pepaslabs/OpAmpPassXsistorBenchSupply/README.md

# OpAmpPassXsistorBenchSupply

An adjustable voltage and current limited lab power supply, implemented with a traditional op amp and pass transistor architecture.

# Status

This design is currently broken (it oscillates).  I haven't had time to revisit it yet.
