pepaslabs/OpAmpPassXsistorBenchSupply/OpAmpPassXsistorBenchSupply_schematic.pdf

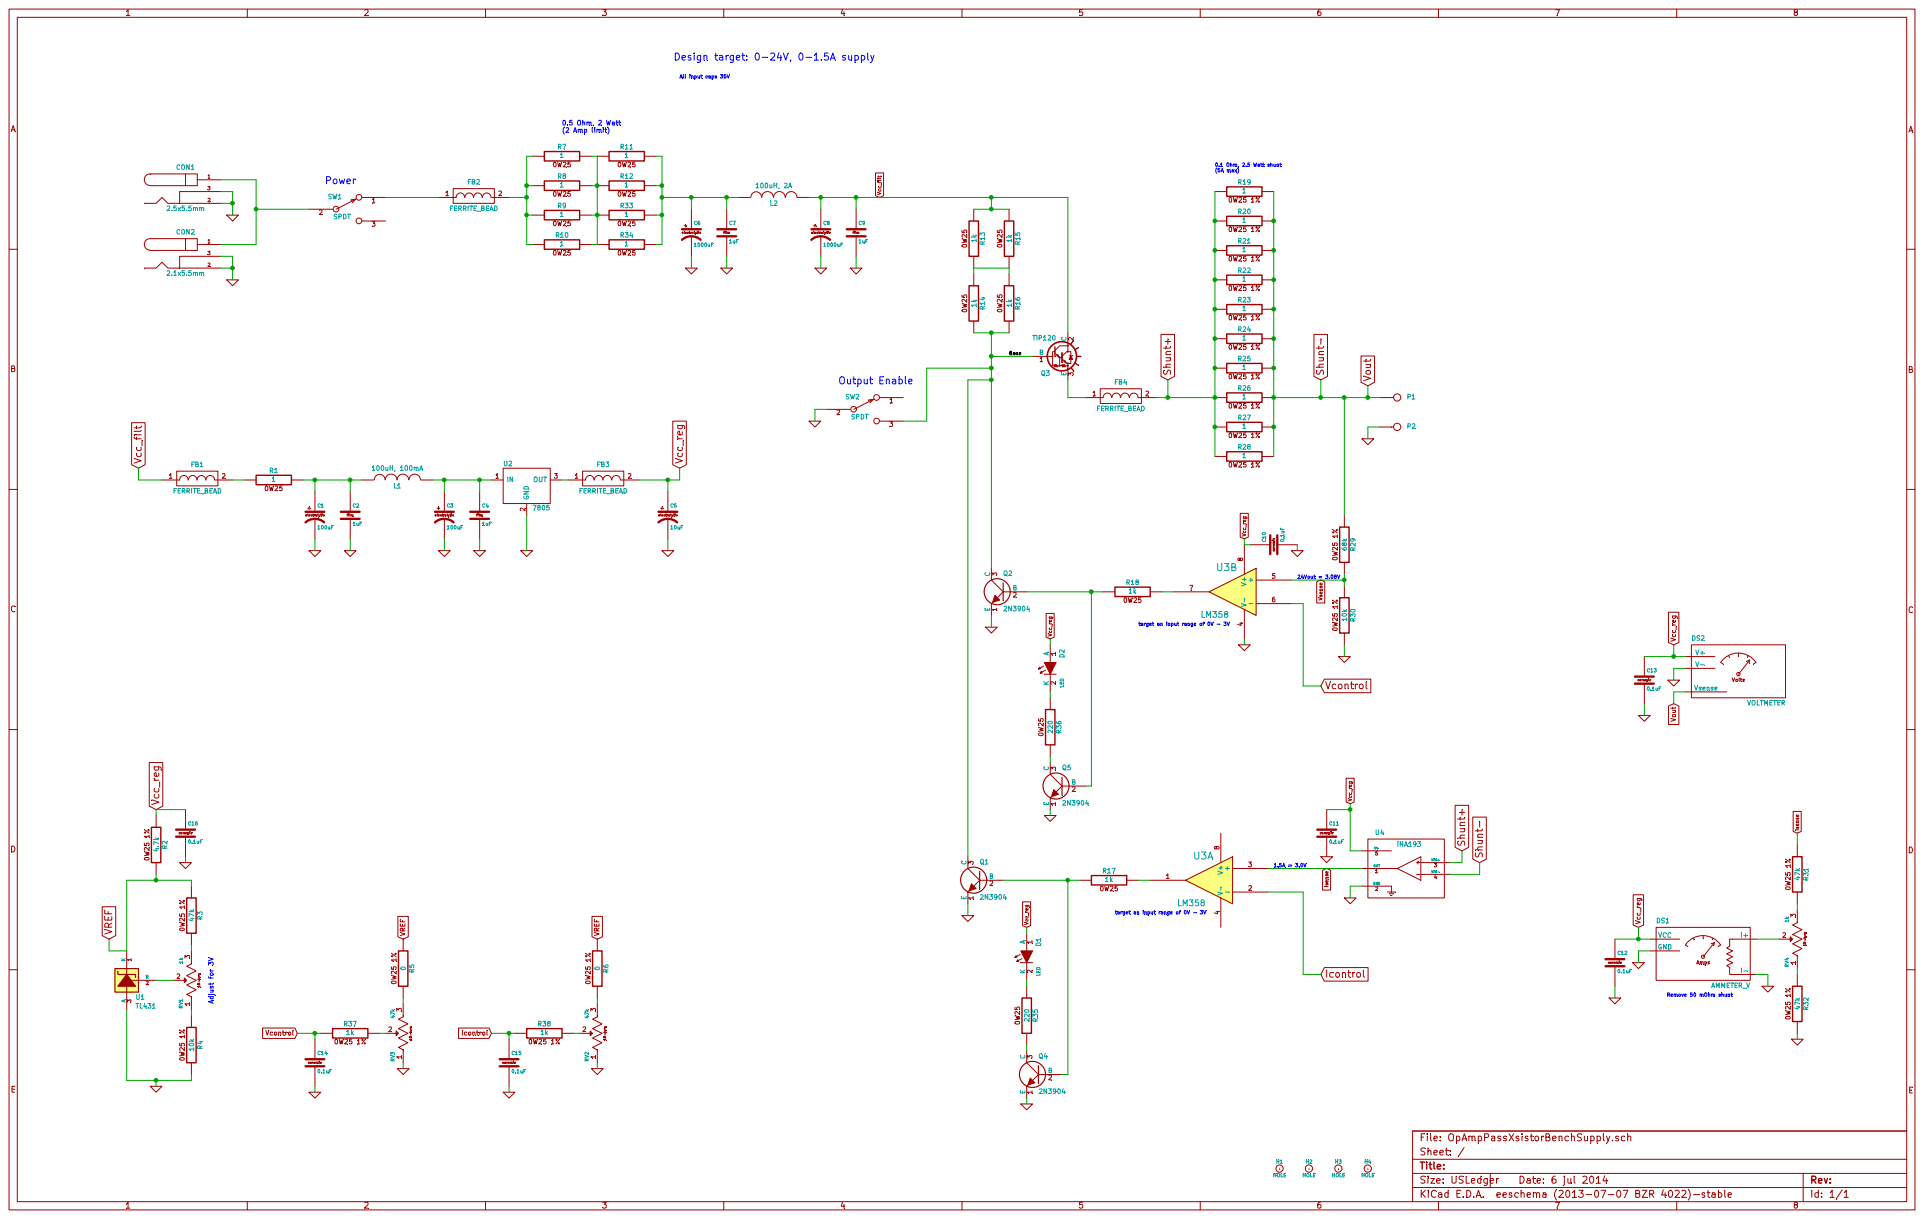
[picture p1: page 1]
