pepaslabs/OpAmpPassXsistorBenchSupply/OpAmpPassXsistorBenchSupply.kicad_pcb

## KiCad design OpAmpPassXsistorBenchSupply.kicad_pcb (2014-07-06)

Schematic: OpAmpPassXsistorBenchSupply.sch

Parts:
C1, C3: 100uF
C2, C4, C7, C9: 1uF
C5: 10uF
C6, C8: 1000uF
C10, C11, C12, C13, C14, C15, C16: 0.1uF
CON1: 2.5x5.5mm
CON2: 2.1x5.5mm
D1, D2: LED
DS1: AMMETER_V
DS2: VOLTMETER
FB1, FB2, FB3, FB4: FERRITE_BEAD
H1, H2, H3, H4: HOLE
L1: 100uH, 100mA
L2: 100uH, 2A
P1, P2: CONN_1
Q1, Q2, Q4, Q5: 2N3904
Q3: TIP120; TO220
R1, R7, R8, R9, R10, R11, R12, R19, R20, R21, R22, R23, R24, R25, R26, R27, R28, R33, R34: 1
R2: 4.7k
R3, R31, R32: 47k
R4, R30: 10k
R5, R6: 0
R13, R14, R15, R16, R17, R18, R37, R38: 1k
R29: 68k
R35, R36: 220
RV1, RV4: 1k
RV2, RV3: 47k
SW1, SW2: SPDT
U1: TL431
U2: 7805
U3: LM358
U4: INA193

Connections:
/Base: Q1.3 (C), Q2.3 (C), Q3.1 (B), R14.2, R16.2, SW2.3
GND: C1.2, C2.2, C3.2, C4.2, C5.2, C6.2, C7.2, C8.2, C9.2, C10.2, C11.2, C12.2, C13.2, C14.2, C15.2, C16.2, CON1.2, CON1.3, CON2.2, CON2.3, DS1.2, DS1.4, DS2.3, P2.1, Q1.1 (E), Q2.1 (E), Q4.1 (E), Q5.1 (E), R4.2, R30.2, R32.2, RV2.1, RV3.1, SW2.2, U1.3 (A), U2.2 (GND), U3.4 (V-), U4.2 (GND)
Icontrol: C15.1, R38.1, U3.2 (-)
Isense: R31.1, U3.3 (+), U4.1 (OUT)
unnamed: R5.2, RV3.3
unnamed: R32.1, RV4.1
unnamed: R31.2, RV4.3
unnamed: DS1.1, RV4.2
unnamed: R6.2, RV2.3
unnamed: CON1.1, CON2.1, SW1.2
unnamed: C6.1, C7.1, L2.1, R11.2, R12.2, R33.2, R34.2
unnamed: R7.2, R8.2, R9.2, R10.2, R11.1, R12.1, R33.1, R34.1
unnamed: RV1.2, U1.2 (R)
unnamed: FB3.1, U2.3 (OUT)
unnamed: FB4.1, Q3.3 (E)
unnamed: FB2.1, SW1.1
unnamed: FB1.2, R1.1
unnamed: R18.2, U3.7
unnamed: R4.1, RV1.1
unnamed: R3.2, RV1.3
unnamed: R17.2, U3.1
unnamed: Q2.2 (B), Q5.2 (B), R18.1
unnamed: Q5.3 (C), R36.2
unnamed: D2.2, R36.1
unnamed: Q4.3 (C), R35.2
unnamed: D1.2, R35.1
unnamed: Q1.2 (B), Q4.2 (B), R17.1
unnamed: R37.2, RV3.2
unnamed: R38.2, RV2.2
unnamed: R13.2, R14.1, R15.2, R16.1
unnamed: C3.1, C4.1, L1.2, U2.1 (IN)
unnamed: FB2.2, R7.1, R8.1, R9.1, R10.1
unnamed: C1.1, C2.1, L1.1, R1.2
Shunt+: FB4.2, R19.1, R20.1, R21.1, R22.1, R23.1, R24.1, R25.1, R26.1, R27.1, R28.1, U4.3 (VIN+)
Shunt-: DS2.1, P1.1, R19.2, R20.2, R21.2, R22.2, R23.2, R24.2, R25.2, R26.2, R27.2, R28.2, R29.1, U4.4 (VIN-)
VREF: R2.2, R3.1, R5.1, R6.1, U1.1 (K)
Vcc_filt: C8.1, C9.1, FB1.1, L2.2, Q3.2 (C), R13.1, R15.1
Vcc_reg: C5.1, C10.1, C11.1, C12.1, C13.1, C16.1, D1.1, D2.1, DS1.3, DS2.2, FB3.2, R2.1, U3.8 (V+), U4.5 (V+)
Vcontrol: C14.1, R37.1, U3.6 (-)
Vsense: R29.2, R30.1, U3.5 (+)

Notes on the sheet:
target an input range of 0V - 3V
24Vout = 3.08V
Design target: 0-24V, 0-1.5A supply
1.5A = 3.0V
Adjust for 3V
Remove 50 mOhm shunt
0.5 Ohm, 2 Watt (2 Amp limit)
0.1 Ohm, 2.5 Watt shunt (5A max)
Output Enable
Power
All input caps 35V

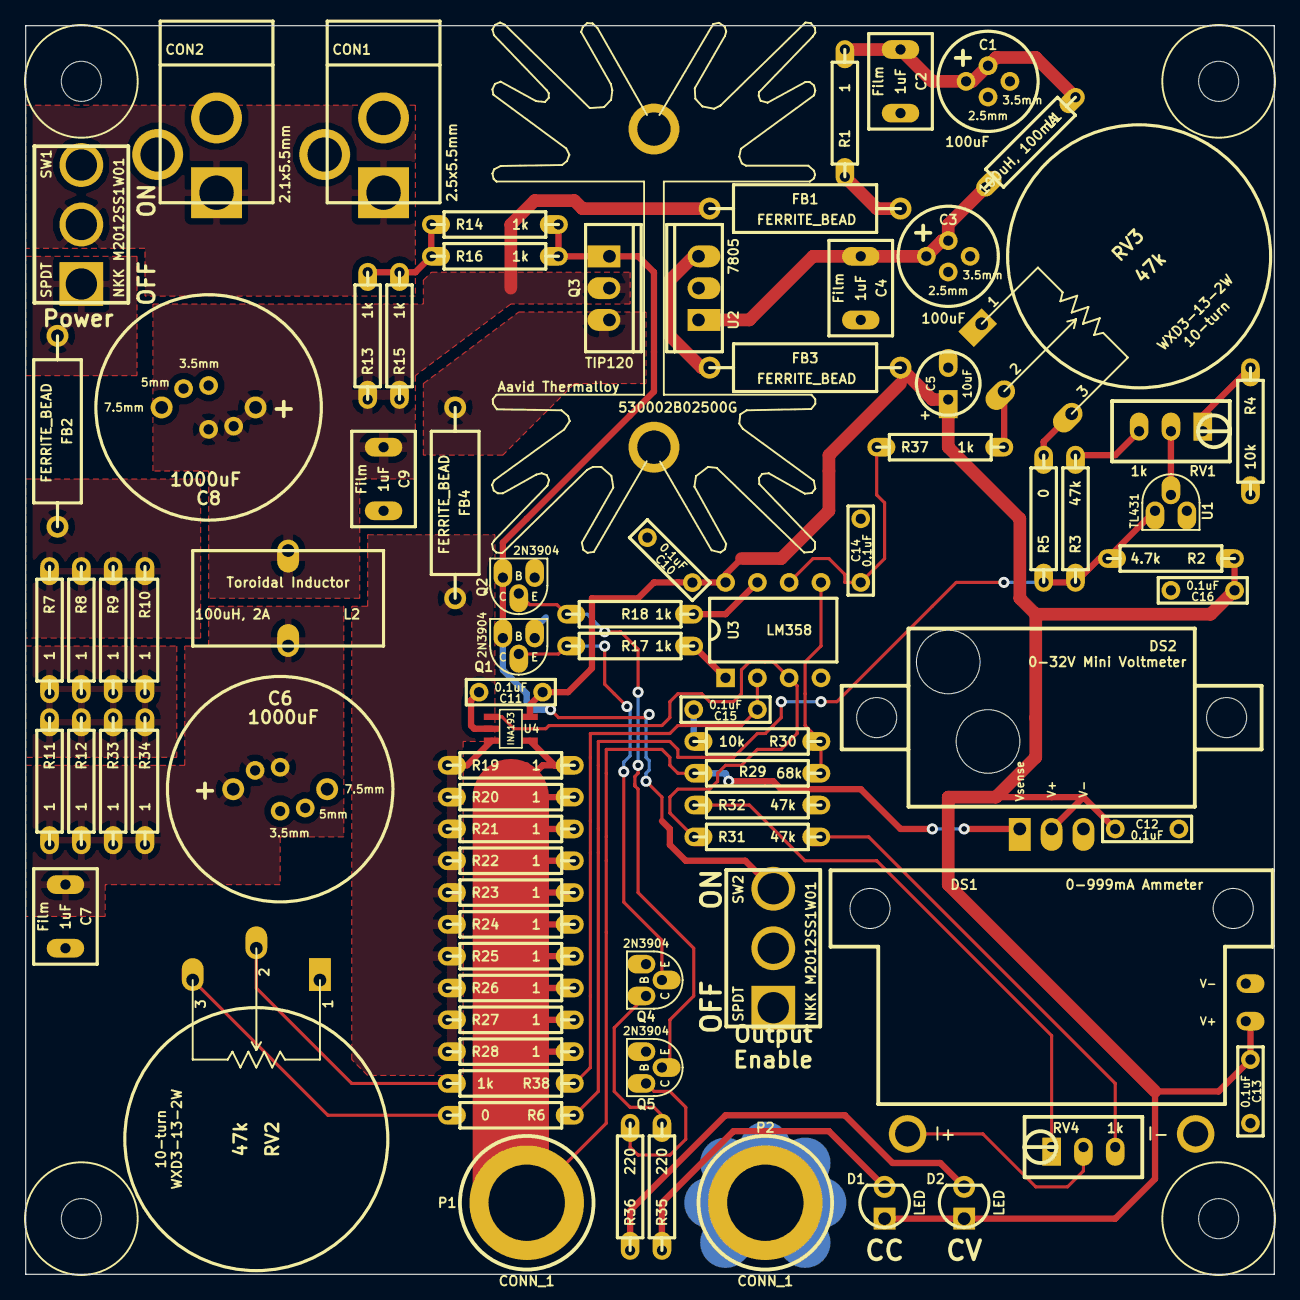
[picture p2: board OpAmpPassXsistorBenchSupply.kicad_pcb from above]

Board: 2 copper layers, 99.7 x 99.7 mm, 88 parts (0 on the bottom side), 40 nets.

Other parts of the board:
H***: 530002B02500G
