pepaslabs/OpAmpPassXsistorBenchSupply/(commit log)

2014-03-29 initial project creation
    [OpAmpPassXsistorBenchSupply.sch]
2014-03-29 pulling in libraries and modules. setting up input jacks and positive and negative supply rails.
    [OpAmpPassXsistorBenchSupply.sch]
2014-03-29 implementing basic voltage control schematic
    [OpAmpPassXsistorBenchSupply.sch]
2014-03-29 adding basic current and power control stubs
    [OpAmpPassXsistorBenchSupply.sch]
2014-03-29 adding input caps
    [OpAmpPassXsistorBenchSupply.sch]
2014-03-29 adding input filter
    [OpAmpPassXsistorBenchSupply.sch]
2014-03-29 working on input filter
    [$OpAmpPassXsistorBenchSupply.sch, OpAmpPassXsistorBenchSupply.sch]
2014-03-29 specifying regulator passive values
    [$OpAmpPassXsistorBenchSupply.sch, OpAmpPassXsistorBenchSupply.sch]
2014-03-29 tweaking filter values
    [OpAmpPassXsistorBenchSupply.sch]
2014-03-29 breaking vcc out into sub sheets
    [OpAmpPassXsistorBenchSupply.sch, Vcc_filter.sch, Vcc_reg.sch, vcc_input.sch]
2014-03-29 breaking Vee out into sub sheets
    [OpAmpPassXsistorBenchSupply.sch, Vcc_filter.sch, Vcc_reg.sch, Vee_filter.sch, Vee_input.sch, Vee_reg.sch, vcc_input.sch]
2014-03-29 breaking out additional subsheets. specifying transistor values.
    [OpAmpPassXsistorBenchSupply.sch, Pass_xsistor.sch, Shunt.sch, Vcc_filter.sch, Vcc_reg.sch, Vee_filter.sch, Vee_input.sch, Vee_reg.sch]
2014-03-29 adding base resistor to pnp.
    [OpAmpPassXsistorBenchSupply.sch, Pass_xsistor.sch]
2014-07-04 WIP. switching to INA193. revisiting input filter.
    [OpAmpPassXsistorBenchSupply.sch, Pass_xsistor.sch, Shunt.sch, Vcc_filter.sch, Vcc_reg.sch, Vee_filter.sch, Vee_input.sch, Vee_reg.sch]
2014-07-04 working on revamp of power supply.
    [OpAmpPassXsistorBenchSupply.kicad_pcb, OpAmpPassXsistorBenchSupply.sch, Pass_xsistor.sch, Shunt.sch, Vcc_filter.sch, Vcc_reg.sch, Vee_filter.sch, Vee_input.sch]
2014-07-06 revision 1 being sent off to PCB house.
    [OpAmpPassXsistorBenchSupply-B_Cu.gbl, OpAmpPassXsistorBenchSupply-B_Mask.gbs, OpAmpPassXsistorBenchSupply-B_SilkS.gbo, OpAmpPassXsistorBenchSupply-Edge_Cuts.gbr, OpAmpPassXsistorBenchSupply-F_Cu.gtl, OpAmpPassXsistorBenchSupply-F_Mask.gts, OpAmpPassXsistorBenchSupply-F_SilkS.gto, OpAmpPassXsistorBenchSupply-NPTH.drl]
2014-07-06 cleaning up old files
    [Pass_xsistor.sch, Shunt.sch, Vcc_filter.sch, Vcc_reg.sch, Vee_filter.sch, Vee_input.sch, Vee_reg.sch, vcc_input.sch]
2014-07-06 updating pdf printout.
